openenergymonitor/emonVs/1.3.2/assets/3d_model_preview.PNG

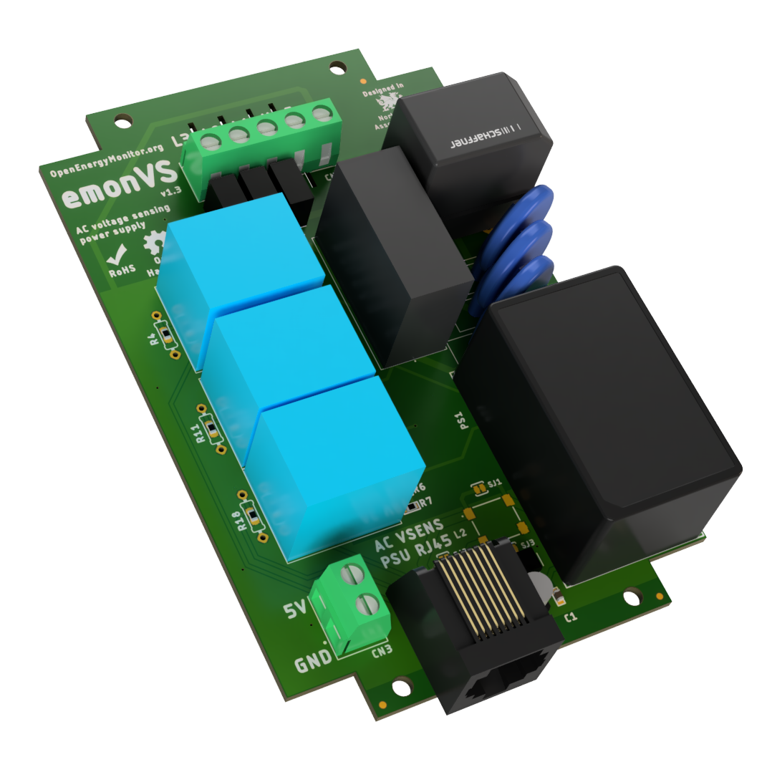
1.3.2/assets/3d_model_preview.PNG
