openenergymonitor/emonVs/assets/emonVS_pcb.png

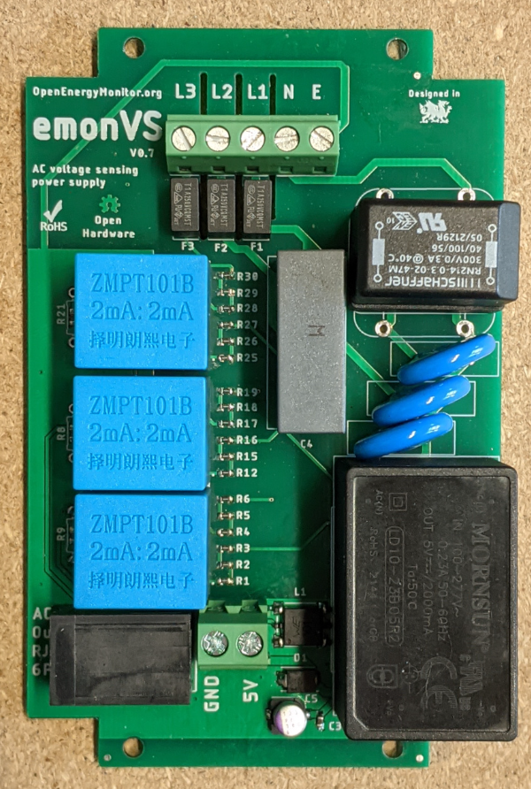
assets/emonVS_pcb.png
