openenergymonitor/emonVs/1.3.2/assets/OSHW.bmp

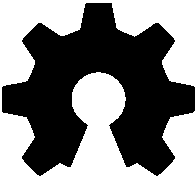
1.3.2/assets/OSHW.bmp
