openenergymonitor/emonVs/1.3.2/assets/RoHS.bmp

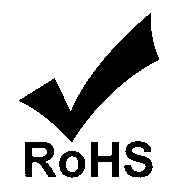
1.3.2/assets/RoHS.bmp
