openenergymonitor/emonVs/1.3.2/brd.png

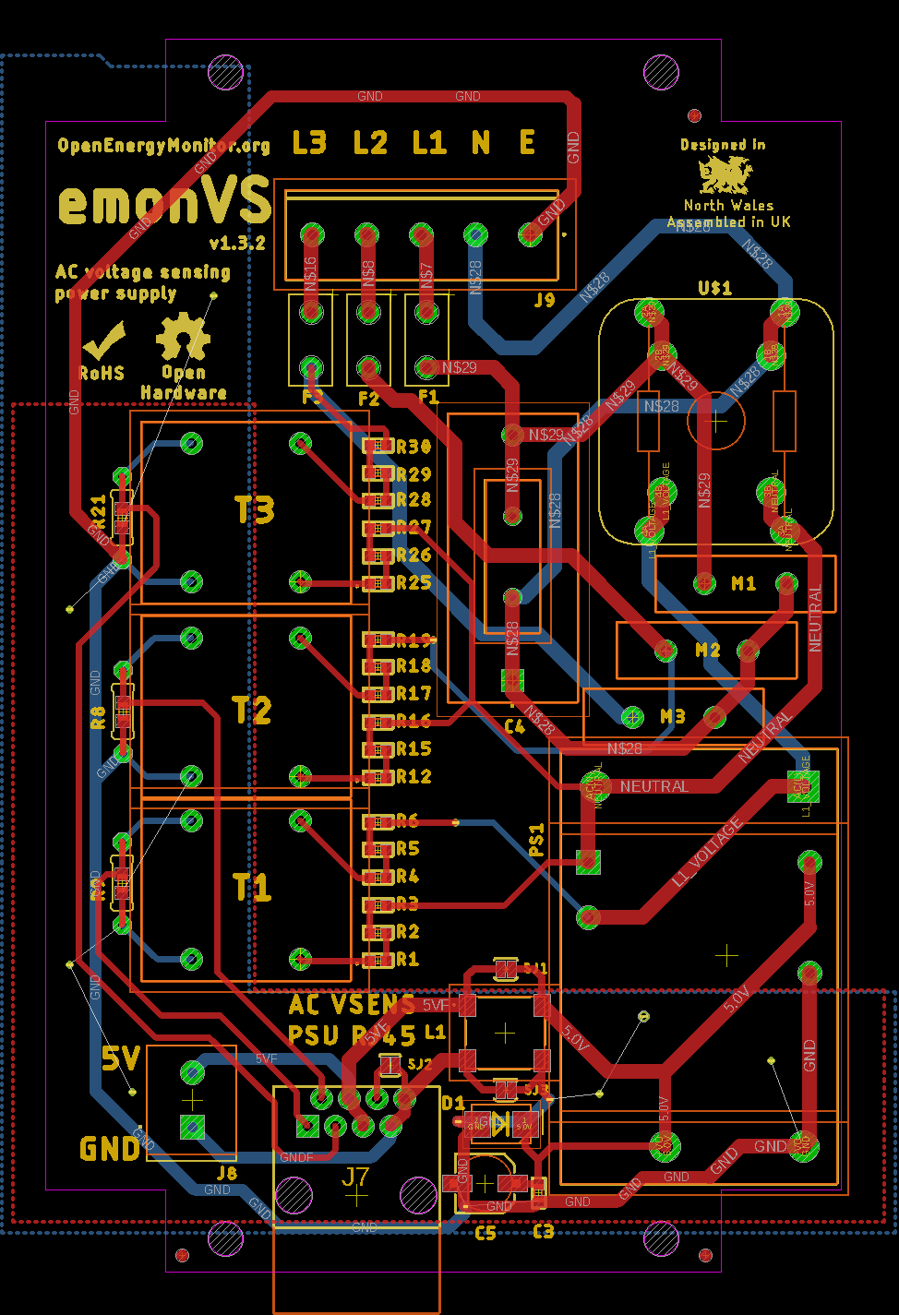
1.3.2/brd.png
