openenergymonitor/emonVs/1.4.2/board.png

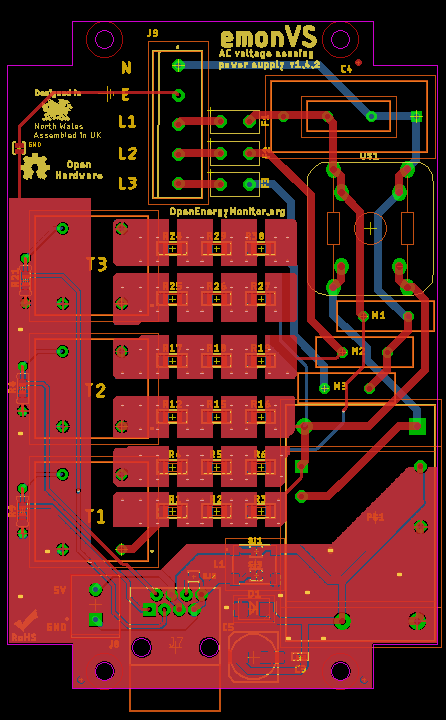
1.4.2/board.png
