openenergymonitor/emonVs/assets/emonVS_device.png

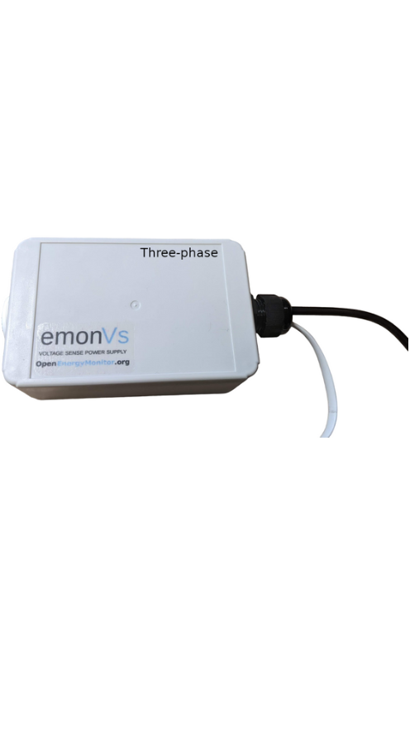
assets/emonVS_device.png
