openenergymonitor/emonVs/datasheets/ZMPT101B-Datasheet.jpg

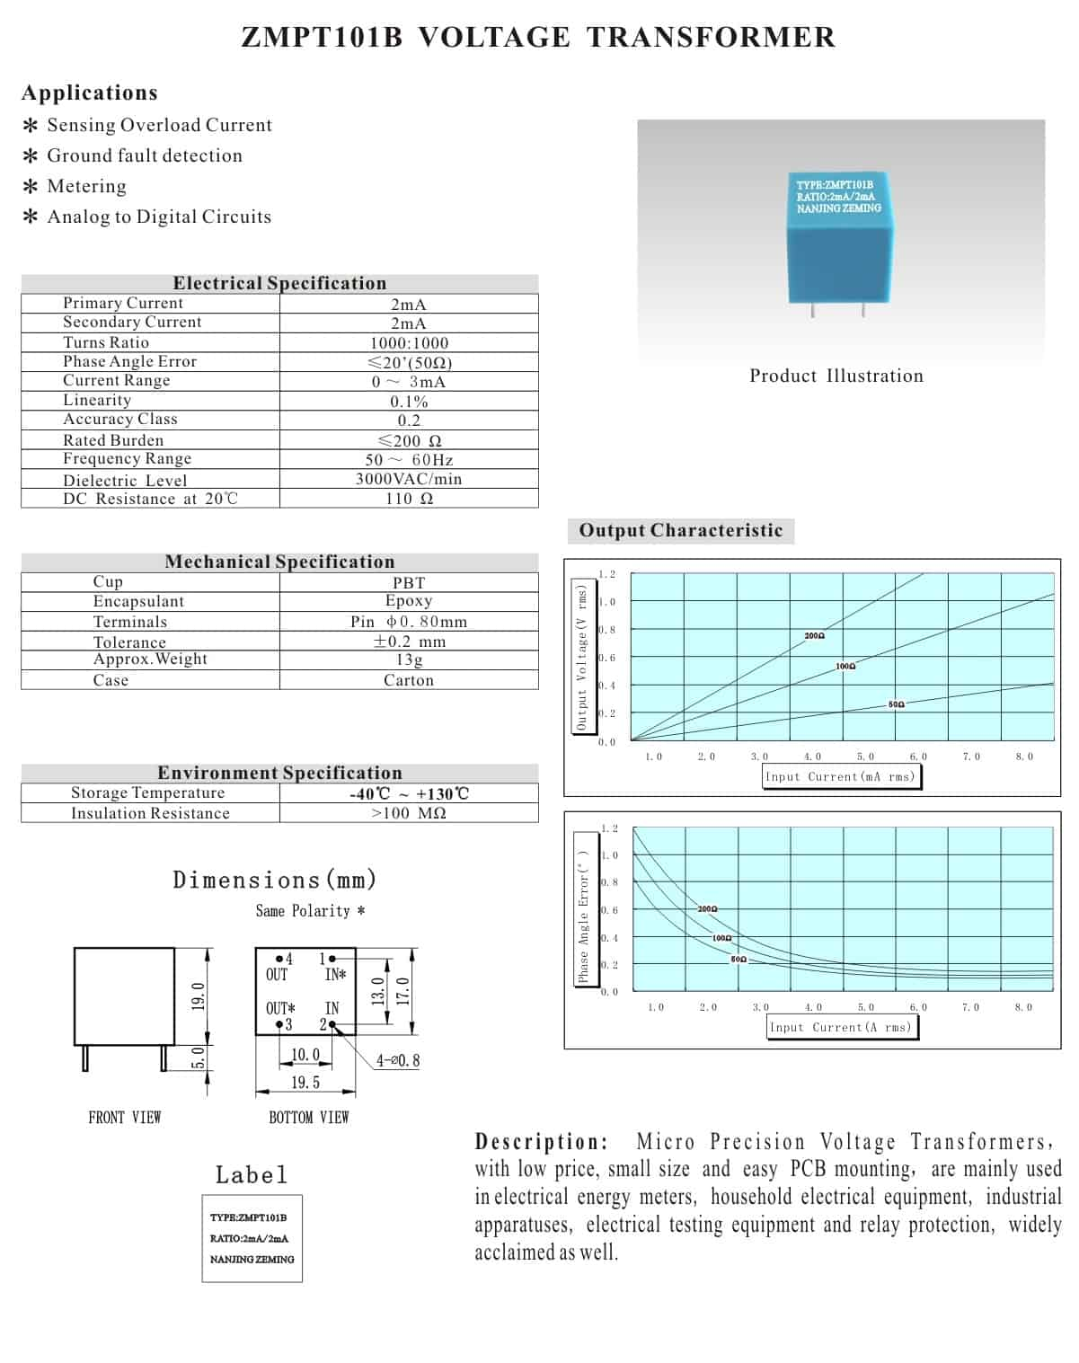
datasheets/ZMPT101B-Datasheet.jpg
