openenergymonitor/emonVs/1.3.2/assets/emonVS v1.3.step

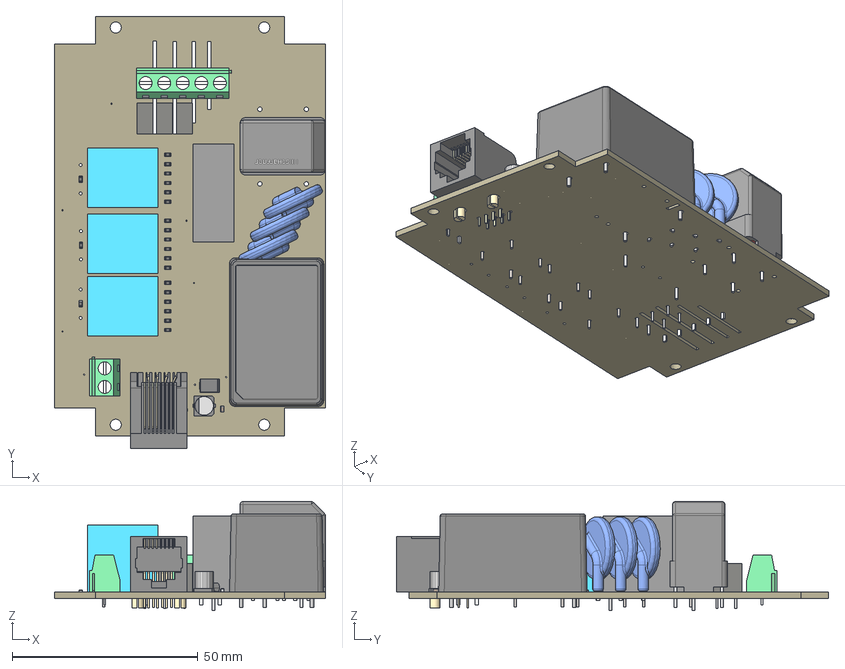
[picture p9: CAD file, 2023-04-26]
1.3.2/assets/emonVS v1.3.step
73.0 x 116.4 x 29.4 mm
Board
FilletPin1
FilletPin2
C0603
OPENENERGYMONITOR_CHOKE_SCHAFFNER
TOP_HOUSING_6
BOTTOM_HOUSING_4
16010014_AF0_2
16010014_AF1_2
16010014_AF2_2
16010014_AF3_2
OPENENERGYMONITOR_C_PTH
OPENENERGYMONITOR_RJ45-8P
OPENENERGYMONITOR_TERMINAL_BLOCK_5P
c-282836-2-j-3d
Extruded3
Extruded1 x 2
Extruded
Extruded2
Board (1)
R0603 x 18
OPENENERGYMONITOR_FUSE x 3
OPENENERGYMONITOR_MOV x 3
OPENENERGYMONITOR_R_PTH_SMD x 3
ZMPT101B x 3
