openenergymonitor/emonVs/1.4.2/schematic.pdf

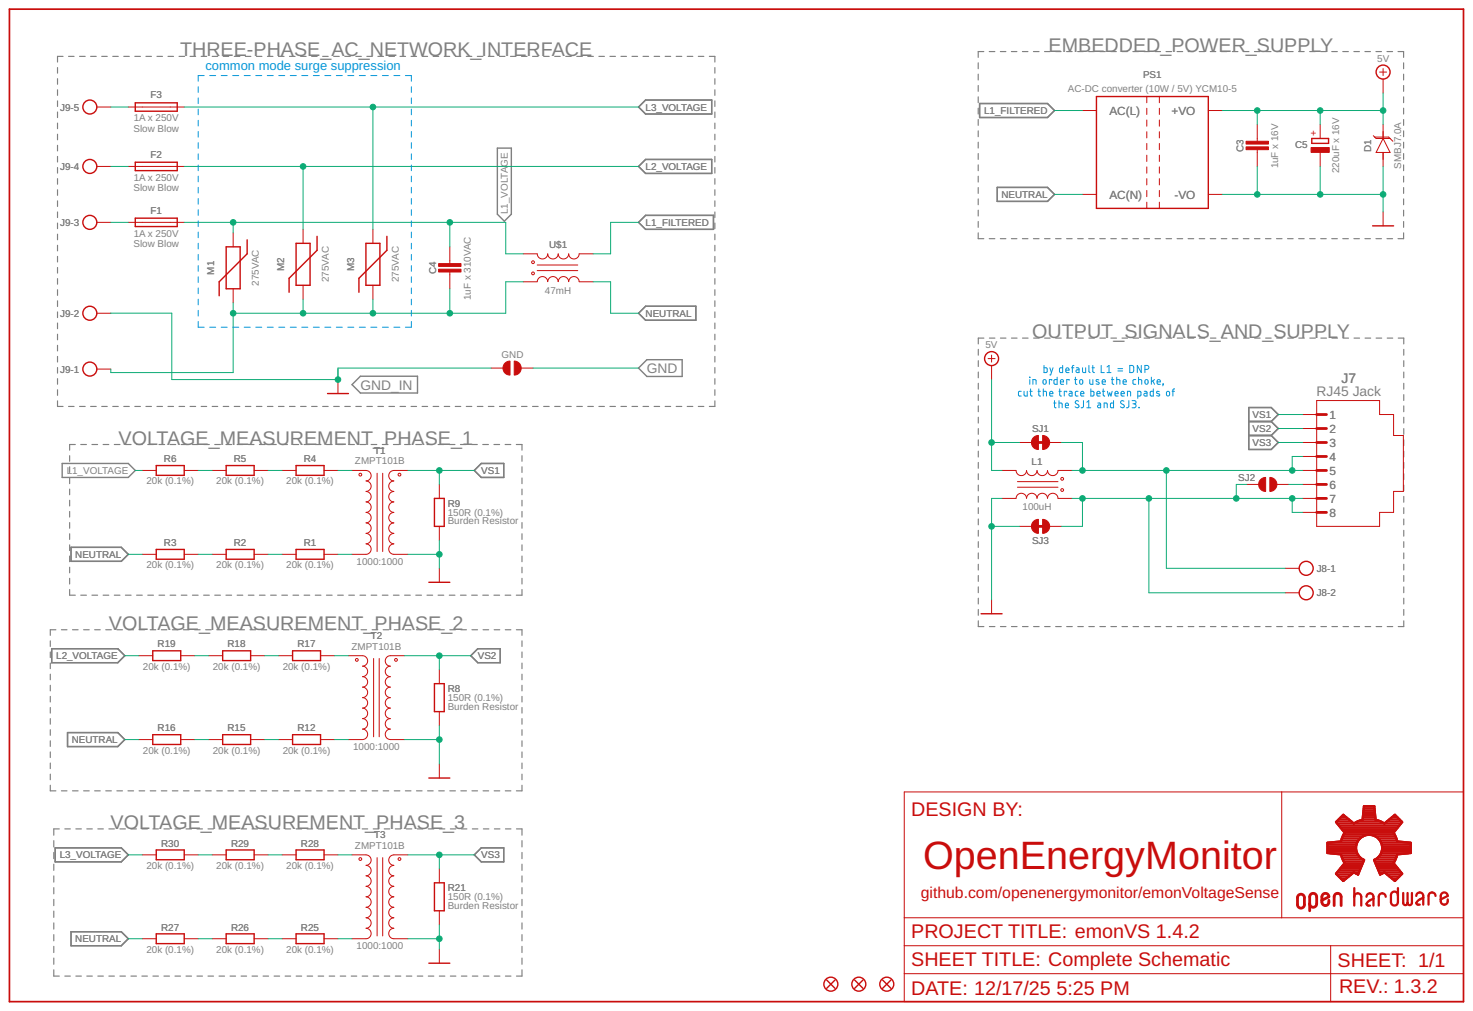
[picture p10: page 1]

THREE-PHASE_AC_NETWORK_INTERFACE
common mode surge suppression

github.com/openenergymonitor/emonVoltageSense
PROJECT TITLE:

SHEET TITLE: Complete Schematic | SHEET: 1/1
DATE: 12/17/25 5:25 PM | REV.: 1.3.2
