openenergymonitor/emonVs/archive/v0.7/sch.pdf

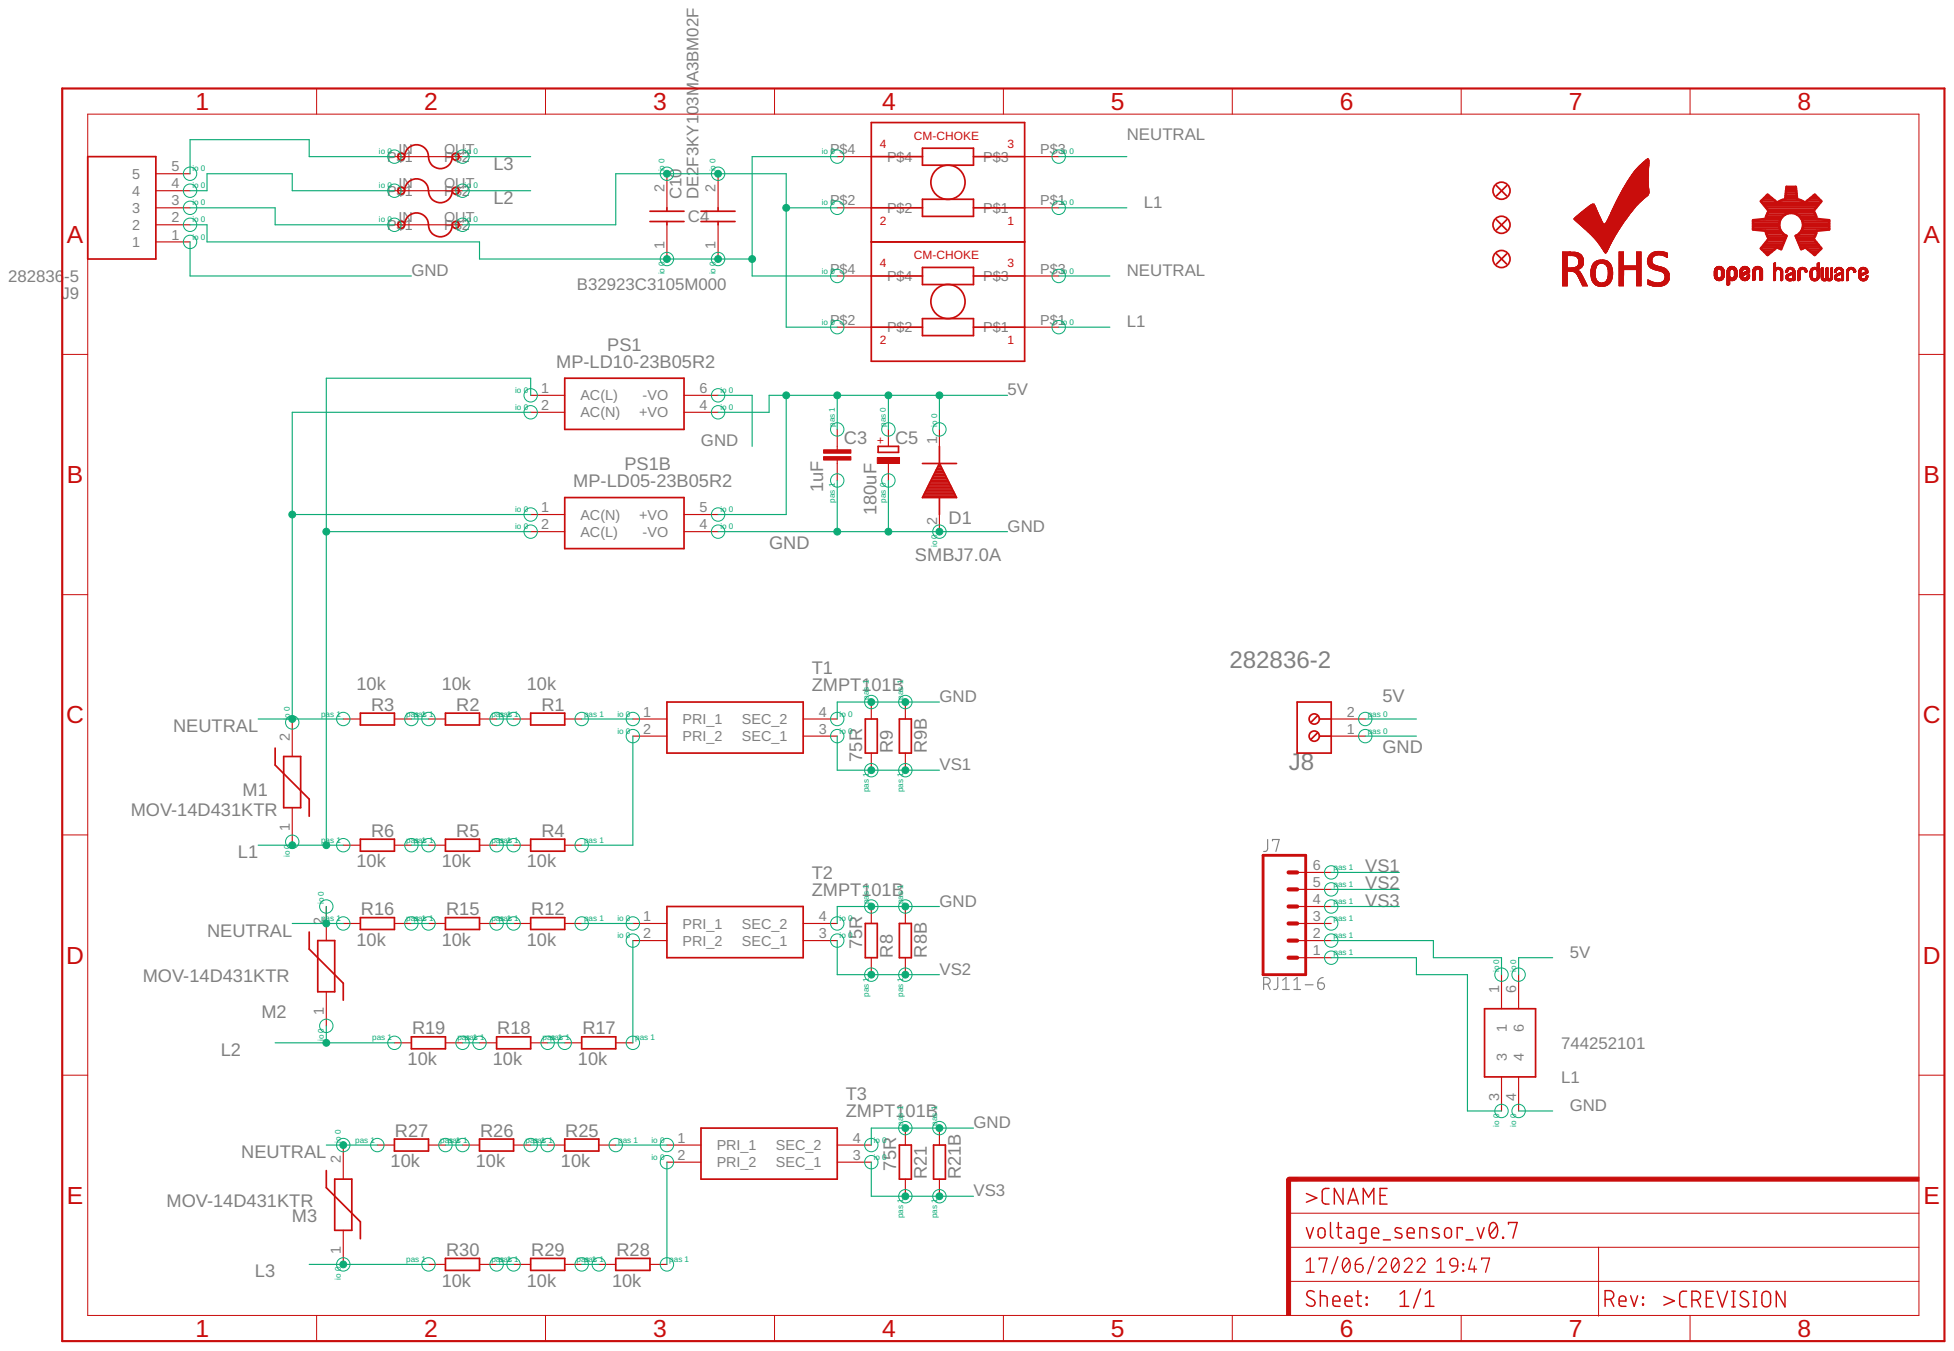
[picture p12: page 1]
