openenergymonitor/emonVs/archive/v0.5/voltage_sensor_v0.5.pdf

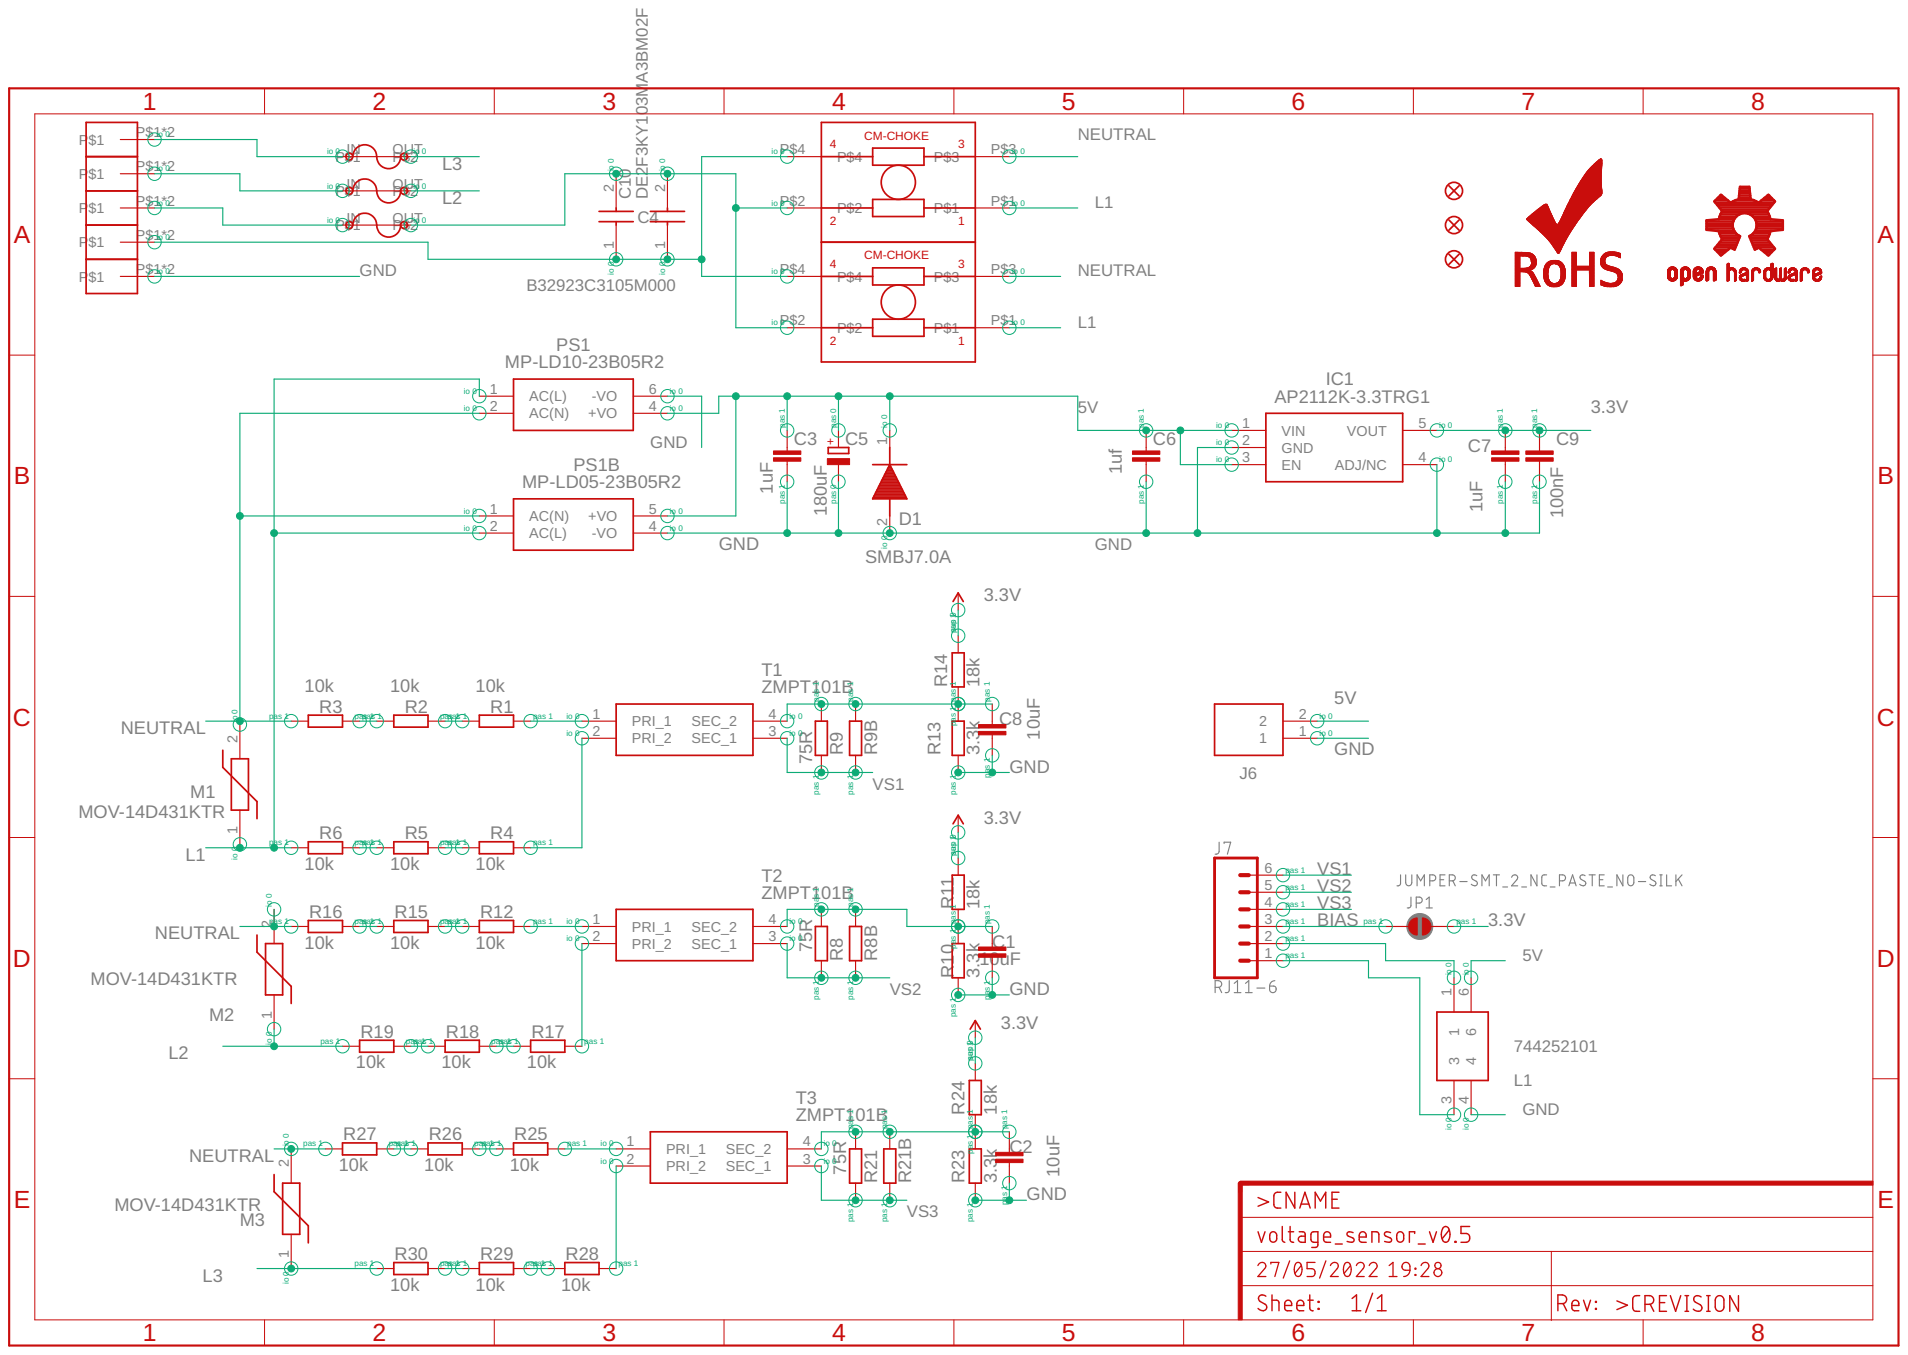
[picture p13: page 1]
