openenergymonitor/emonVs/archive/v0.4/voltage_sensor_v0.4.pdf

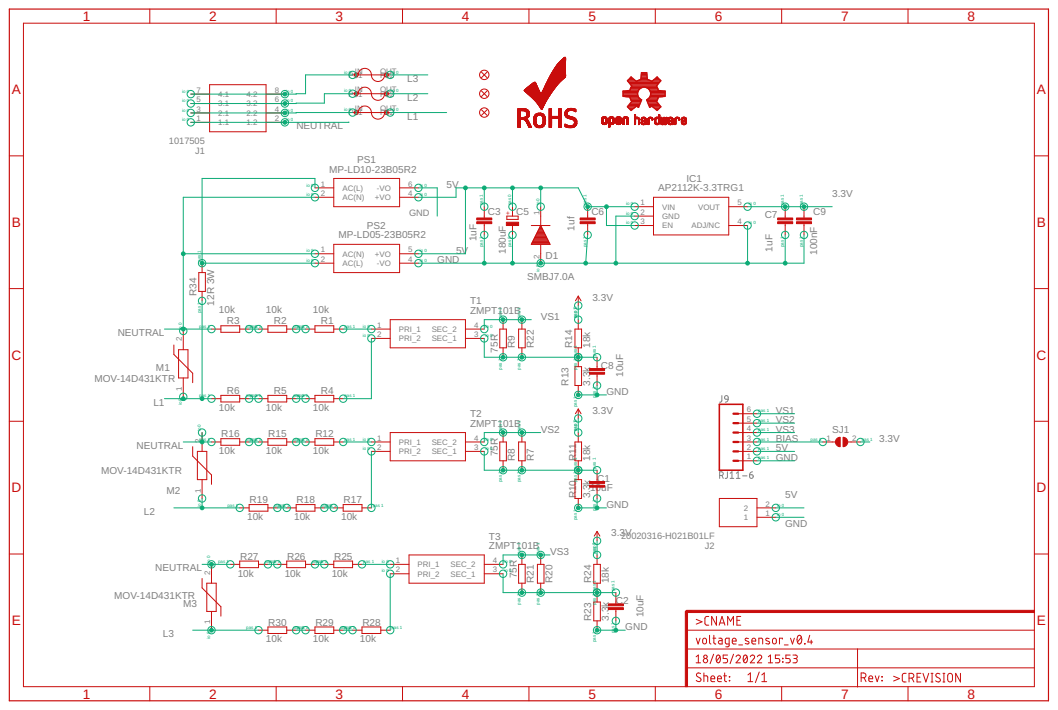
[picture p14: page 1]
