openenergymonitor/emonVs/archive/v0.3/sch.pdf

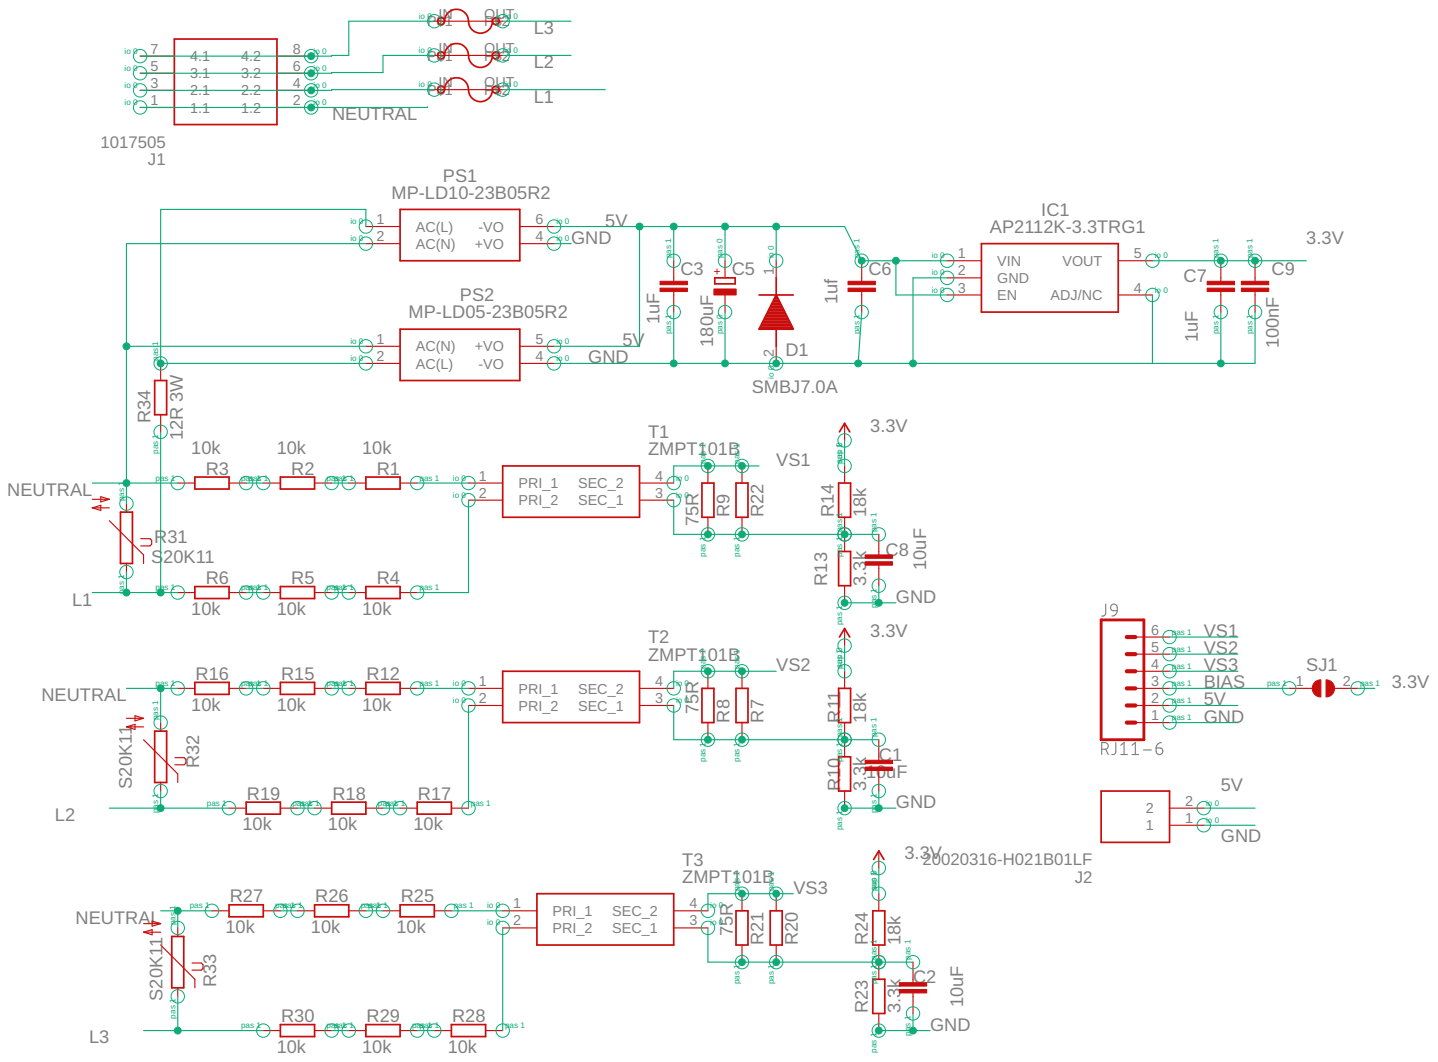
[picture p15: page 1]

pas 1 pas 1 pas 1 pas 1 sup 0
