openenergymonitor/emonVs/archive/v0.2/voltage_sensor_v0.2.pdf

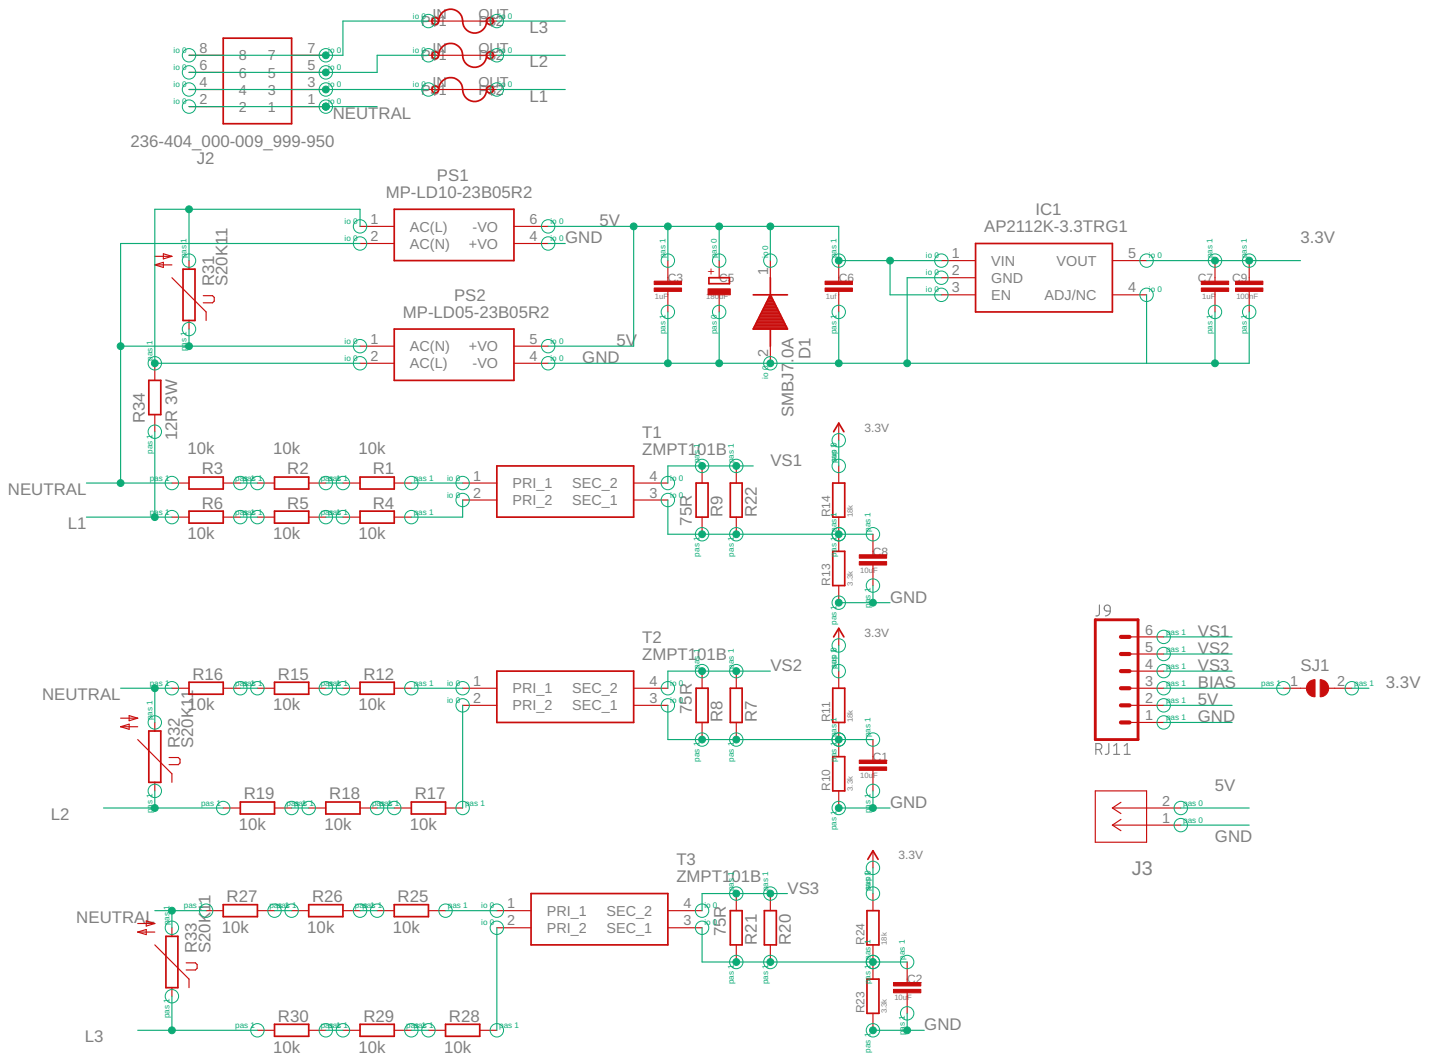
[picture p16: page 1]

pas 1 pas 1 pas 1 pas 1 sup 0
