openenergymonitor/emonVs/mini/emonVS_mini.brd

## EAGLE design mini/emonVS_mini.brd (2024-08-27)

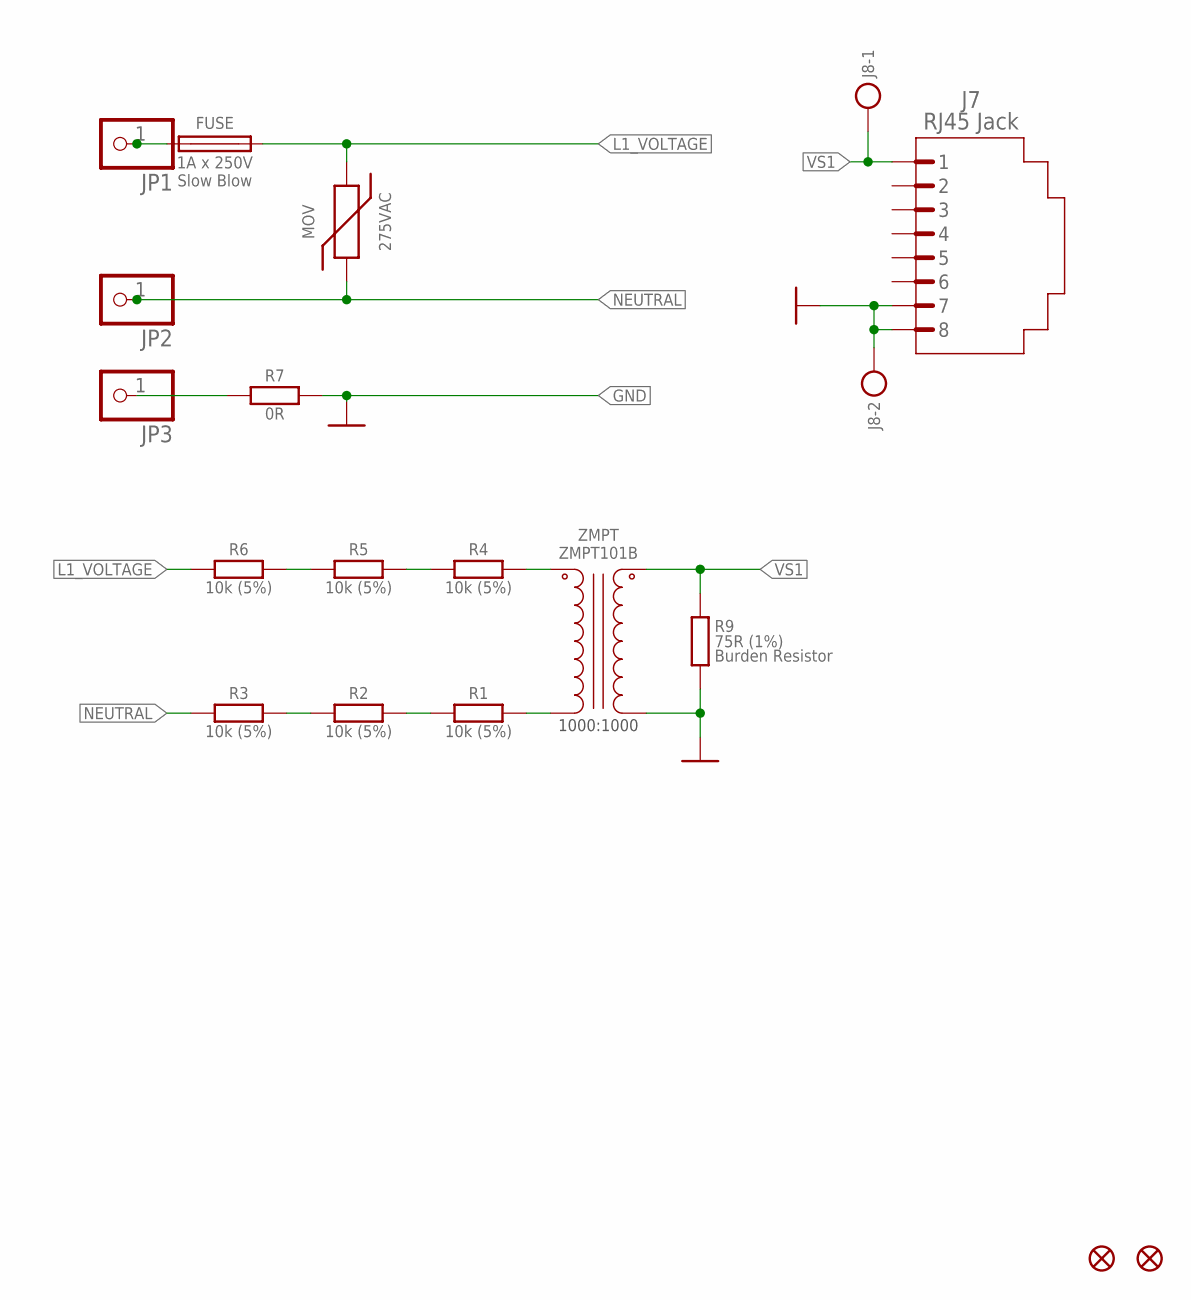
[picture p19: schematic emonVS_mini.sch, Complete Schematic]

Parts:
FD1, FD2: FIDUCIAL1X2; FIDUCIAL
FUSE: 1A x 250V; FUSE
J7: RJ45 Jack; RJ45-8P
J8: TERMINAL_BLOCK_2P
JP1, JP2, JP3: PINHD-1X1; 1X01
MOV: 275VAC; MOV
R1, R2, R3, R4, R5, R6: 10k (5%); R1206
R7: 0R; R1206
R9: 75R (1%); R_PTH_SMD
ZMPT: ZMPT101B

Connections:
GND: J7.7, J7.8, J8.1, R7.1, R9.1A (2), R9.1B (2), ZMPT.4 (SEC_1)
L1_VOLTAGE: FUSE.OUT (1), MOV.1 (2), R6.2
unnamed: R4.1, ZMPT.2 (PRI_1)
unnamed: R1.1, ZMPT.1 (PRI_2)
unnamed: R1.2, R2.1
unnamed: R4.2, R5.1
unnamed: R5.2, R6.1
unnamed: R2.2, R3.1
unnamed: FUSE.IN (2), JP1.1
unnamed: JP3.1, R7.2
NEUTRAL: JP2.1, MOV.2 (1), R3.2
VS1: J7.1, J8.2, R9.2A (1), R9.2B (1), ZMPT.3 (SEC_2)

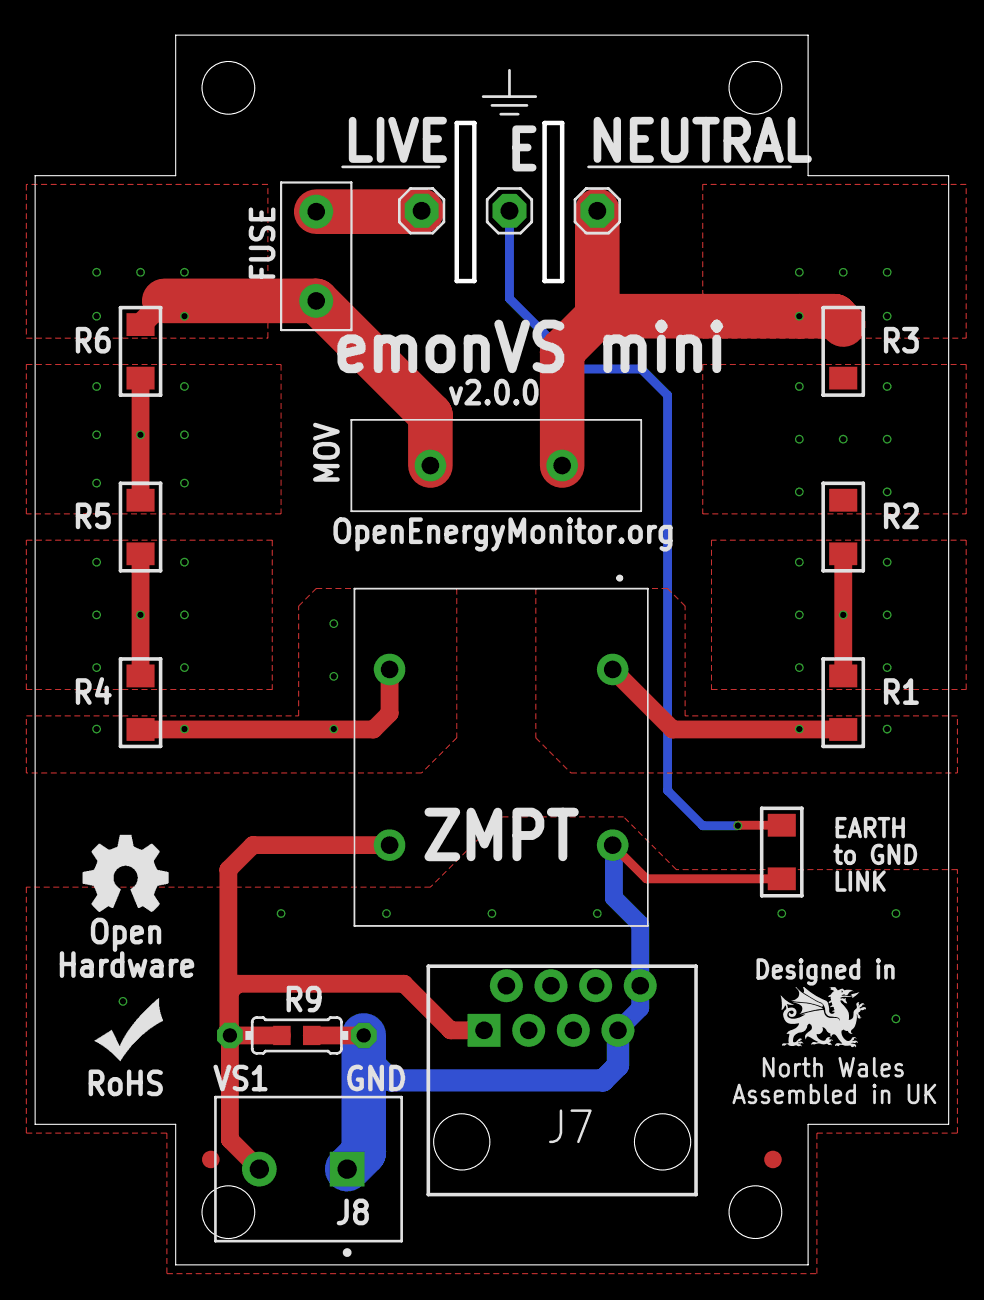
[picture p20: board emonVS_mini.brd from above]

Board: 2 copper layers, 52.0 x 70.0 mm, 18 parts (0 on the bottom side), 12 nets.
