openenergymonitor/emonVs/(commit log)

2022-05-04 fist commit
    [voltage_sensor.brd, voltage_sensor.sch, voltage_sensor_v0.2.brd, voltage_sensor_v0.2.sch]
2022-05-04 fix resistor footprint and value
    [voltage_sensor_v0.2.brd, voltage_sensor_v0.2.sch]
2022-05-04 improve clearance
    [voltage_sensor_v0.2.brd]
2022-05-04 rename change log
    [voltage_sensor_v0.3.brd, voltage_sensor_v0.3.sch]
2022-05-15 increase footprint of C5
    [voltage_sensor_v0.3.brd, voltage_sensor_v0.3.sch]
2022-05-15 v0.3 changes
    [voltage_sensor_v0.3.brd, voltage_sensor_v0.3.sch]
2022-05-18 fix PSU 10W footprint
    [voltage_sensor_v0.4.brd, voltage_sensor_v0.4.sch]
2022-05-24 add filter components
    [voltage_sensor_v0.4.brd, voltage_sensor_v0.4.sch]
2022-05-24 new board size
    [voltage_sensor_v0.5.brd, voltage_sensor_v0.5.sch]
2022-05-25 new design
    [voltage_sensor_v0.5.brd, voltage_sensor_v0.5.sch]
2022-05-26 finish layout
    [voltage_sensor_v0.5.brd, voltage_sensor_v0.5.sch]
2022-05-27 v0.5 release
    [voltage_sensor_v0.5.brd, voltage_sensor_v0.5.sch]
2022-05-30 add welsh dragon
    [voltage_sensor_v0.5.brd]
2022-08-04 tidy up
    [voltage_sensor.brd, voltage_sensor.sch, voltage_sensor_v0.2.brd, voltage_sensor_v0.2.sch, voltage_sensor_v0.3.brd, voltage_sensor_v0.3.sch, voltage_sensor_v0.4.brd, voltage_sensor_v0.4.sch]
2022-08-08 bump v1.0
    [voltage_sensor_v1.0.brd, voltage_sensor_v1.0.sch]
2022-08-09 add pnp data
    [copper_bottom.gbl, copper_top.gtl, gerber_job.gbrjob, profile.gko, silkscreen_bottom.gbo, silkscreen_top.gto, soldermask_bottom.gbs, soldermask_top.gts]
2022-08-30 V1.1 rev2
    [PnP_voltage_sensor_v1.1_front.csv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]
2023-04-17 v1.2 with R45
    [voltage_sensor_v1.2_RJ45.brd, voltage_sensor_v1.2_RJ45.sch]
2023-04-23 v1.3 release
    [emonVS v1.3.step, emonVS.brd, emonVS.sch, voltage_sensor_v1.1_rev2.brd, voltage_sensor_v1.1_rev2.sch, voltage_sensor_v1.2_RJ45.brd, voltage_sensor_v1.2_RJ45.sch]
2023-04-26 Update BoM
2023-04-26 Renumbered resistor designators to be backwards compatible with older versions
    [emonVS.brd, emonVS.sch]
2023-05-04 increase power track size
    [emonVS.brd]
2023-06-16 rename V1.3.1
    [emonVS v1.3.step, emonVS.brd, emonVS.sch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]
2024-08-25 v1.4 of emonVs
    [emonVS.brd, emonVS.sch]
2024-08-25 minor emonVs changes 1.4
    [emonVS.brd, emonVS.sch]
2024-08-25 emonVs mini v2
    [emonVS_mini.brd, emonVS_mini.sch]
2024-08-27 improved thermal, swap around earth neutral, 0R link option
    [emonVS.brd, emonVS.sch, emonVS_mini.brd, emonVS_mini.sch]
2025-12-17 connect GND via solder jumper
    [emonVS 1.4.2.brd, emonVS 1.4.2.sch]
